kaanytr/ebkdrive/README.md

# ebkdrive
An open-source sensored BLDC controller board that integrates all necessary components into a compact form factor which is 65x65mm. I designed it to be a cost effective and reliable motor driver solution for e-bikes, scooters, skateboards etc.
The controller board integrates STM32 blackpill as the microcontroller. 
The buck converter on the board steps down 36V battery input to 5V for powering the microcontroller. And a step-up converter boosts that 5V to 12V in order to supply the gate driver ICs. 
For now, it runs on open loop speed control by using a potentiometer which can be substituted for a throttle lever. 
The board is designed to work with 36 V but, considering the the parts I have chosen, it should tolerate 48 V operation as well.

https://www.youtube.com/shorts/Ij17WwWdD78

Continious Current capacity : 15A without heat sinking ,
Peak Current : 30A

You can download and import the STM32CubeIDE project to edit to your liking. Or, you can directly flash the ebkdrive_v1.elf file that is found in the debug folder. In either case you have to determine your phase directions by trying different phase and hall sensor arrangements according to your motor. Automatic commutation detection is on the way!
I have the STM32F401CDU6 version of the black pill but software will work for other versions as well.
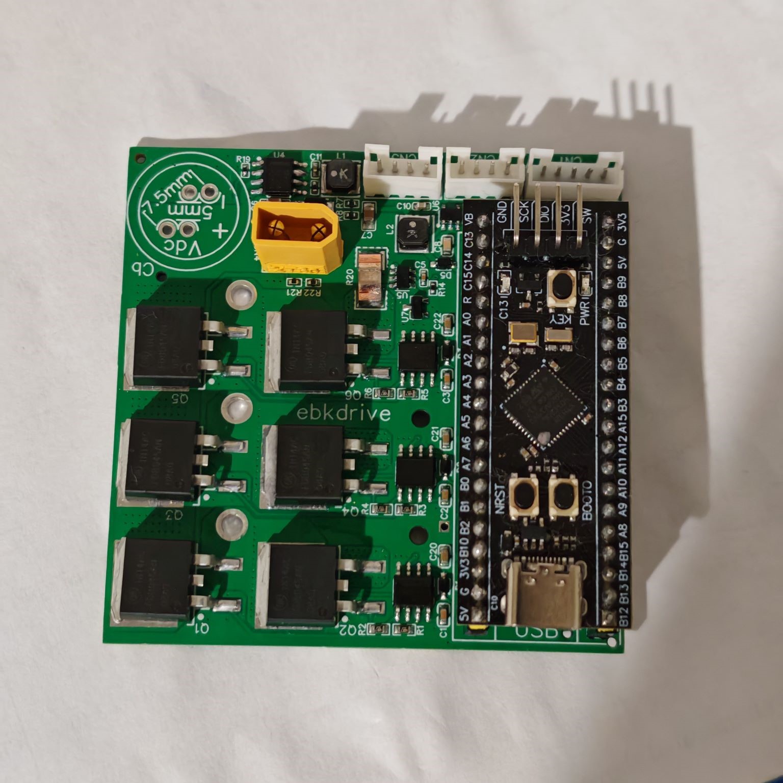
[picture p1: images/top_board.jpg]

 I ordered my PCB assembly from JLCPCB. I only ordered tiny capacitors, resistors and diodes to be pre soldered to the board to keep the special component fee low. Later, I soldered every other component by myself using hot air station and soldering paste. Nonetheless, you can order the PCB assembly as is even though some parts could be out of stock. Which one can substitute for pin-to-pin exactly same functioning parts. I recommend at least 470uF 63V electrolytic capacitor to be soldered for the bus capacitor. Both 5mm and 7.5mm capacitor lead spacing slots can be used. There are 2 M2 screw holes on the board which are intended for securing the board onto a housing. 
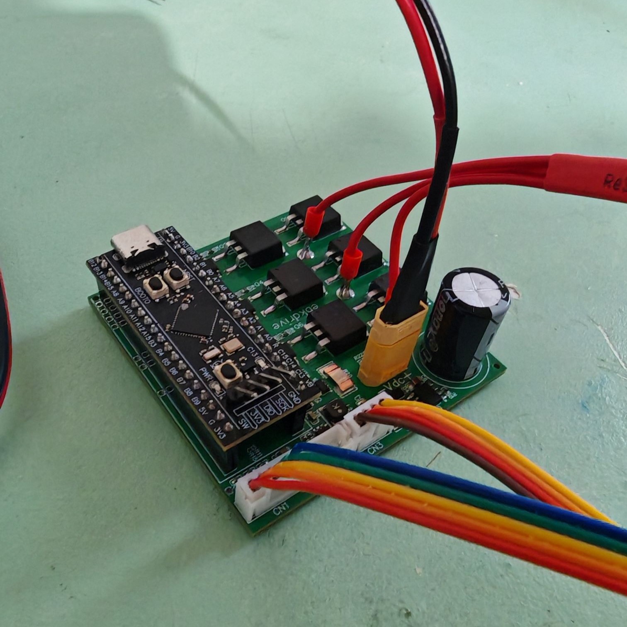
[picture p2: images/board_wired.jpg]
 
## Future scope :
  * Enabling regenerative braking
  * Integrating SSD1106 OLED screen interface to display real-time data, such as motor speed and power consumption. It's going to utilize I2C pins on the connector CN2.
  * Automatic commutation sequence recognition
