kaanytr/ebkdrive/images/3D.png

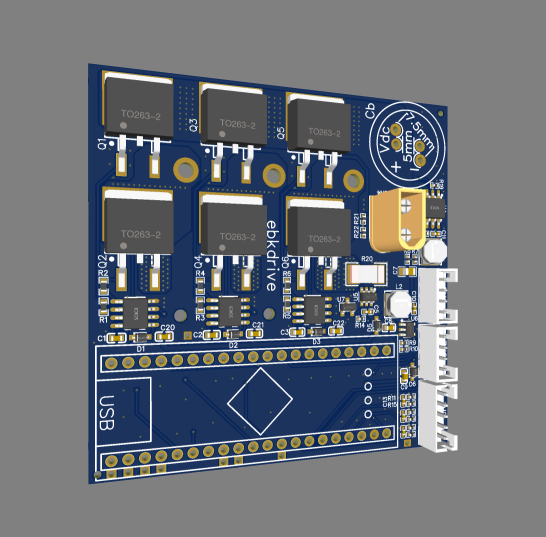
images/3D.png
