kaanytr/ebkdrive/images/board.jpg

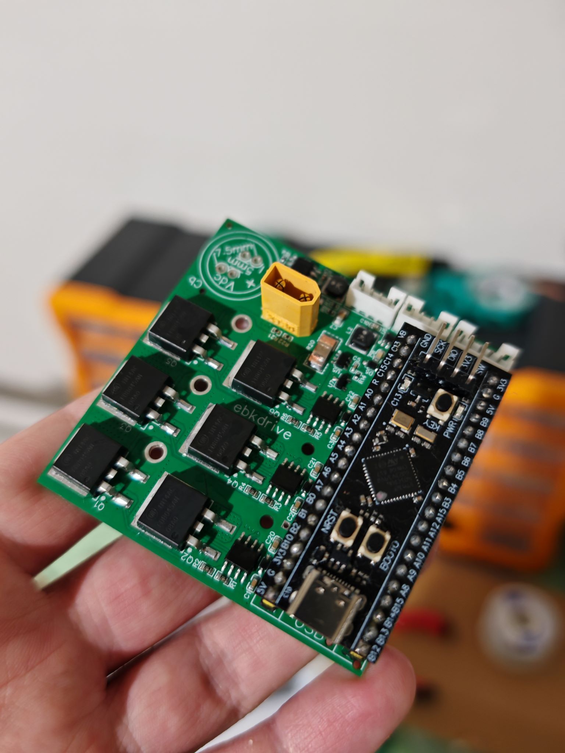
images/board.jpg
