kaanytr/ebkdrive/images/board_right.jpg

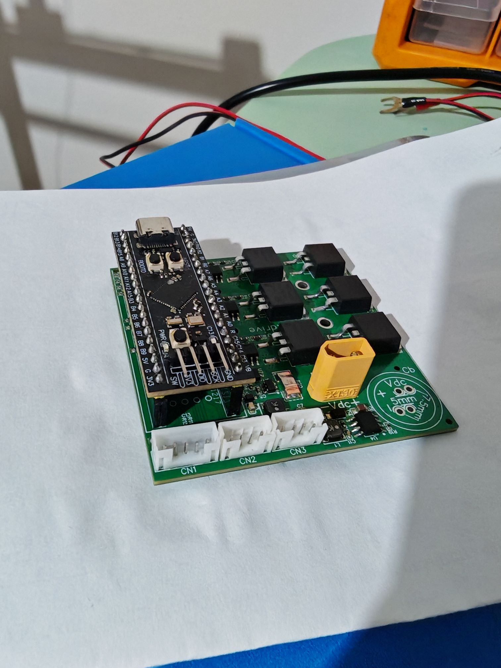
images/board_right.jpg
