kaanytr/ebkdrive/images/Bottom_layer.png

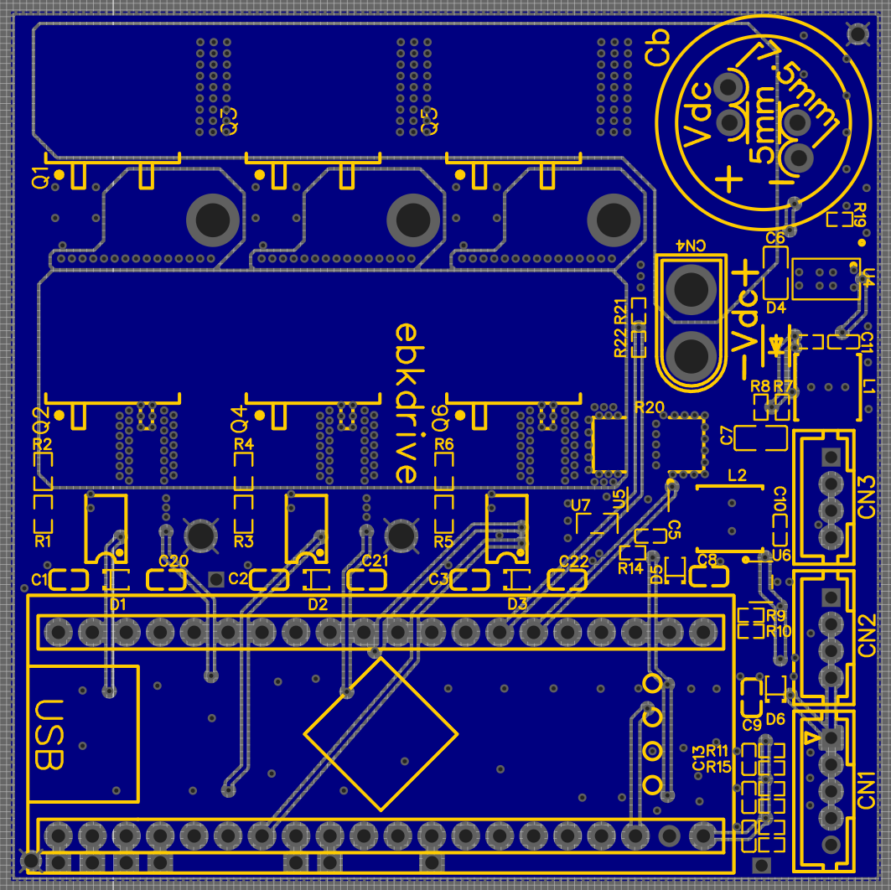
images/Bottom_layer.png
