kaanytr/ebkdrive/images/Top_layer.png

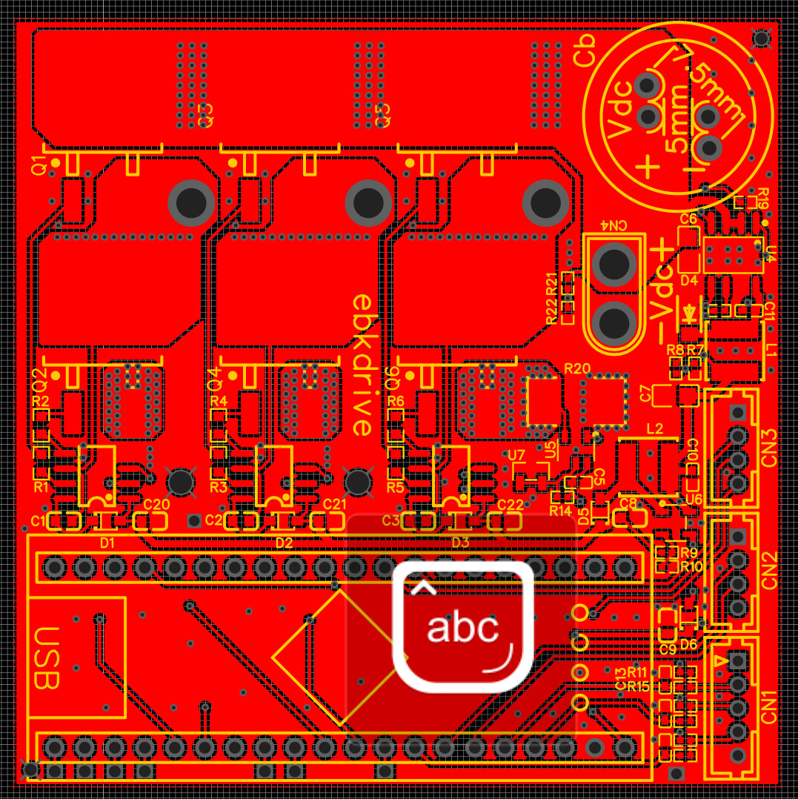
images/Top_layer.png
