kaanytr/ebkdrive/BOM_ebkdrive.ods

ID | Name | Designator | Footprint | Quantity | Manufacturer Part | Manufacturer | Supplier | Supplier Part
1 | 200kΩ | R9,R17 | R0402 | 2 | 0402WGF2003TCE | UNI-ROYAL(厚声) | LCSC | C25764
2 | 22kΩ | R10 | R0402 | 1 | 0402WGF2202TCE | UNI-ROYAL(厚声) | LCSC | C25768
3 | FDB045AN08 | Q1,Q2,Q3,Q4,Q5,Q6 | TO-263-3 | 6 | FDB045AN08 | ONS (FAIRCHILD) | LCSC
4 | IR2103STRPBF | U1,U2,U3 | SOIC-8_L5.0-W4.0-P1.27-LS6.0-BL | 3 | IR2103STRPBF | Infineon(英飞凌) | LCSC | C2957
5 | B5B-PH-K-S-(LF)(SN) | CN1 | CONN-TH_B5B-PH-K-S-LF-SN | 1 | B5B-PH-K-S(LF)(SN) | JST | LCSC | C157993
6 | XT30U-M | CN4 | CONN-TH_XT30U-M | 1 | XT30U-M | AMASS(艾迈斯) | LCSC | C99101
7 | 10uF | C6 | C0805 | 1 | GRM21BR61H106KE43L | muRata(村田) | LCSC | C440198
8 | 100nF | C5 | C0402 | 1 | CL05B104KB54PNC | SAMSUNG(三星) | LCSC | C307331
9 | 100nF | C11 | C0402 | 1 | CL05B104KO5NNNC | SAMSUNG(三星) | LCSC | C1525
10 | DSK36_C22466353 | D4 | SOD-123FL_L2.8-W1.9-LS3.7-RD | 1 | DSK36 | 宏迦橙 | LCSC | C22466353
11 | 4.7Ω | R2,R3,R4,R5,R6,R1 | R0603 | 6 | 0603WAF470KT5E | UNI-ROYAL(厚声) | LCSC | C23164
12 | 49.9kΩ | R19 | R0402 | 1 | 0402WGF4992TCE | UNI-ROYAL(厚声) | LCSC | C25897
13 | 4.7uF | C20,C21,C22 | C0603 | 3 | CL10A475KO8NNNC | SAMSUNG(三星) | LCSC | C19666
14 | 12kΩ | R7 | R0402 | 1 | 0402WGF1202TCE | UNI-ROYAL(厚声) | LCSC | C25752
15 | 68kΩ | R8 | R0402 | 1 | 0402WGF6802TCE | UNI-ROYAL(厚声) | LCSC | C36871
16 | 1N5819WS | D1,D2,D3,D5,D6 | SOD-323_L1.8-W1.3-LS2.5-RD | 5 | 1N5819WS | Hottech(合科泰) | LCSC | C191023
17 | 330pF | C13,C14,C15 | C0402 | 3 | CL05C331JB5NNNC | SAMSUNG(三星) | LCSC | C13533
18 | 2.2kΩ | R11,R12,R13 | R0402 | 3 | 0402WGF2201TCE | UNI-ROYAL(厚声) | LCSC | C25879
19 | 6.8kΩ | R15,R16,R18 | R0402 | 3 | 0402WGF6801TCE | UNI-ROYAL(厚声) | LCSC | C25917
20 | 510Ω | R14 | R0402 | 1 | 0402WGF5100TCE | UNI-ROYAL(厚声) | LCSC | C25123
21 | 22uF | C7 | C0805 | 1 | CL21A226MAQNNNE | SAMSUNG(三星) | LCSC | C45783
22 | 10uF | C8,C9 | C0603 | 2 | CL10A106MA8NRNC | SAMSUNG(三星) | LCSC | C96446
23 | 10uF | C10 | C0402 | 1 | CL05A106MQ5NUNC | SAMSUNG(三星) | LCSC | C15525
24 | 56kΩ | R21 | R0402 | 1 | 0402WGF5602TCE | UNI-ROYAL(厚声) | LCSC | C25796
25 | 3.3kΩ | R22 | R0402 | 1 | 0402WGF3301TCE | UNI-ROYAL(厚声) | LCSC | C25890
26 | 470nF | C1,C2,C3 | C0603 | 3 | CL10B474KA8NNNC | SAMSUNG(三星) | LCSC | C1623
27 | B4B-PH-K-S-(LF)(SN) | CN2,CN3 | CONN-TH_B4B-PH-K-S-LF-SN | 2 | B4B-PH-K-S-(LF)(SN) | JST Sales America | LCSC | C160257
