kaanytr/ebkdrive/schematics.pdf

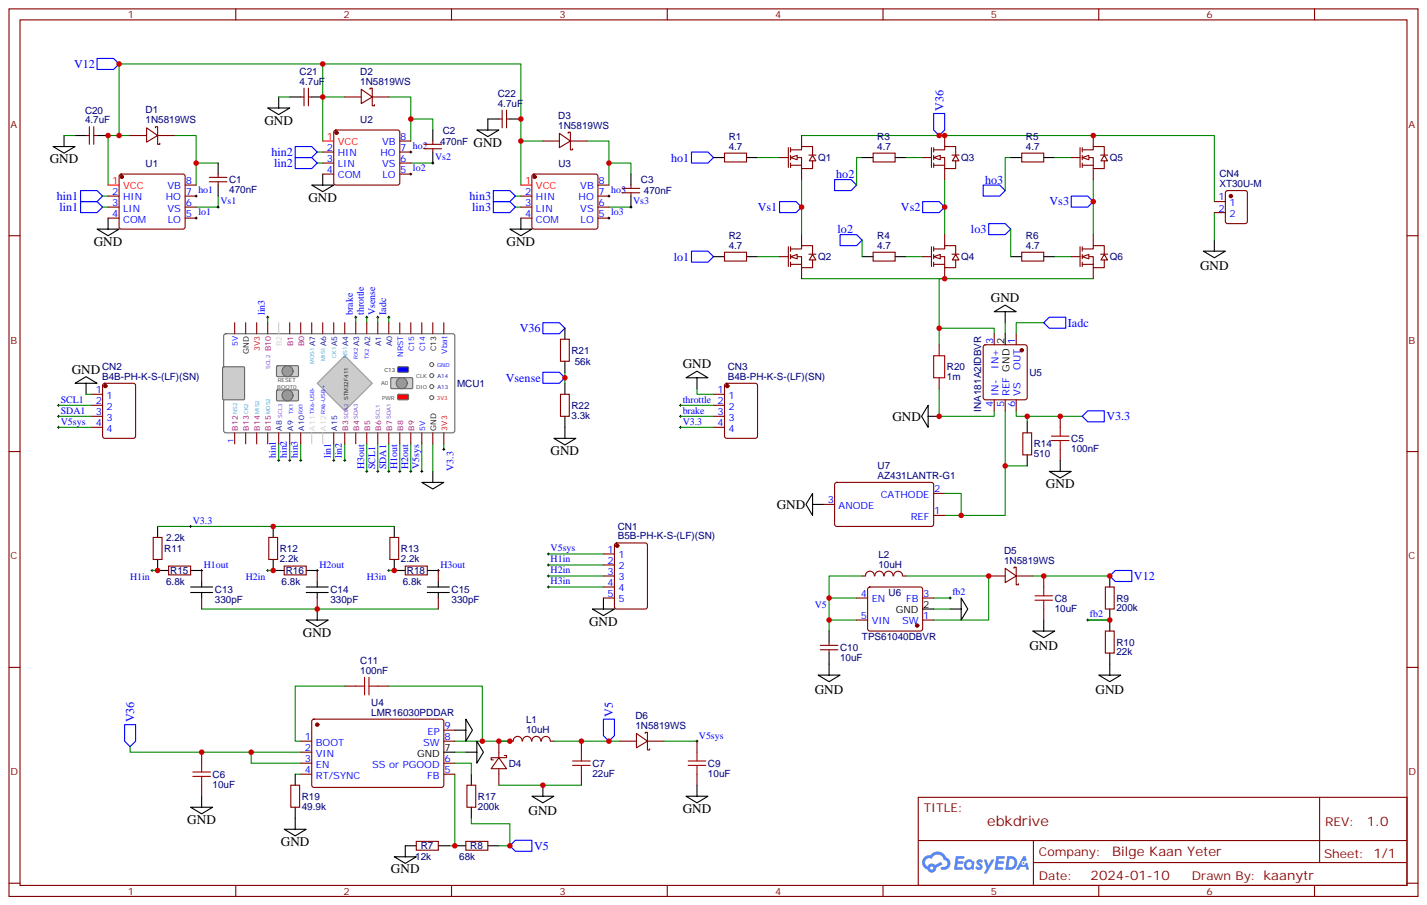
[picture p8: page 1]

Company: Bilge Kaan Yeter
