kaanytr/ebkdrive/images/unsoldered.jpg

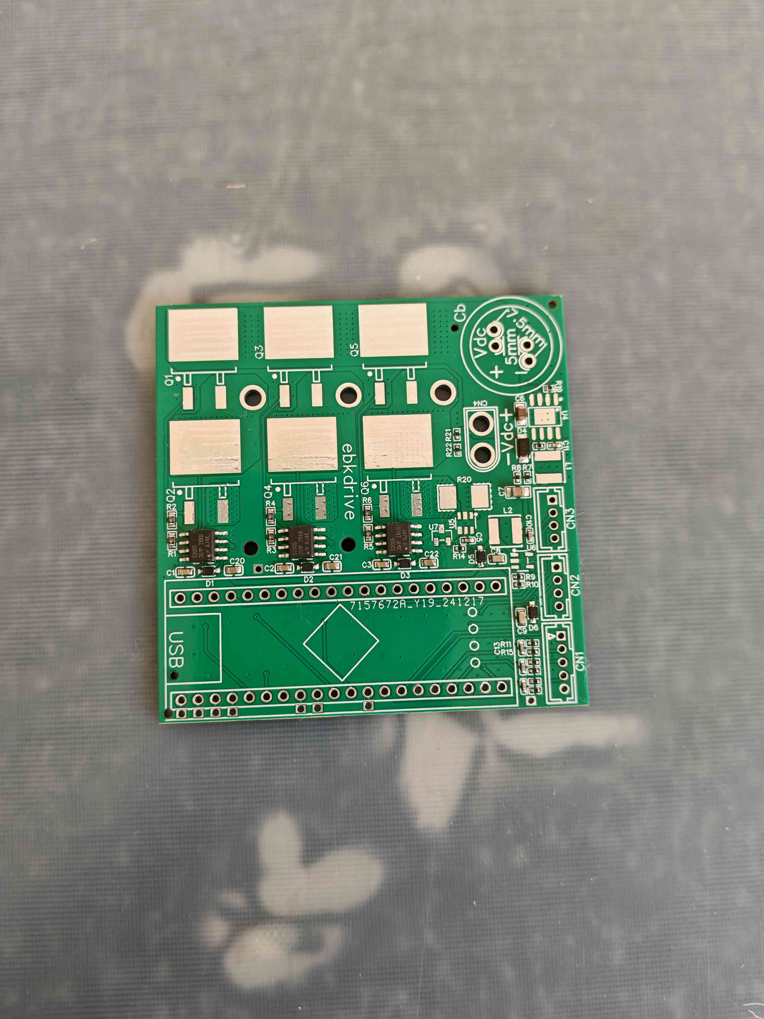
images/unsoldered.jpg
