kaanytr/ebkdrive/ebkdrive_v1/Core/Src/main.c

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
/* Includes ------------------------------------------------------------------*/
#include "main.h"

/* USER CODE BEGIN PD */
#define halla GPIO_PIN_8
#define hallb GPIO_PIN_9
#define hallc GPIO_PIN_5
/* USER CODE END PD */

ADC_HandleTypeDef hadc1;
DMA_HandleTypeDef hdma_adc1;

TIM_HandleTypeDef htim1;
TIM_HandleTypeDef htim3;

/* USER CODE BEGIN PV */
   uint8_t hallSensorState = 0b00000000;
   uint32_t buffer=0;
   uint32_t adc_val=0;
/* USER CODE END PV */

void SystemClock_Config(void);
static void MX_GPIO_Init(void);
static void MX_DMA_Init(void);
static void MX_TIM1_Init(void);
static void MX_TIM3_Init(void);
static void MX_ADC1_Init(void);
/* USER CODE BEGIN 0 */
void HAL_ADC_ConvCpltCallback(ADC_HandleTypeDef* hadc)
{
	if(buffer>50)
	{adc_val=buffer/4;}
    else
	adc_val=0;
}

void HAL_GPIO_EXTI_Callback(uint16_t GPIO_Pin)
{
	hallSensorState = 0;
    hallSensorState |= HAL_GPIO_ReadPin(GPIOB, GPIO_PIN_8) << 0;
    hallSensorState |= HAL_GPIO_ReadPin(GPIOB, GPIO_PIN_9) << 1;
    hallSensorState |= HAL_GPIO_ReadPin(GPIOB, GPIO_PIN_5) << 2;
}

void delay_us (uint16_t us)
{
	__HAL_TIM_SET_COUNTER(&htim3,0);  // set the counter value a 0
	while (__HAL_TIM_GET_COUNTER(&htim3) < us);  // wait for the counter to reach the us input in the parameter
}
/* USER CODE END 0 */

/**
  * @brief  The application entry point.
  * @retval int
  */
int main(void)
{

  /* MCU Configuration--------------------------------------------------------*/

  /* Reset of all peripherals, Initializes the Flash interface and the Systick. */
  HAL_Init();

  /* Configure the system clock */
  SystemClock_Config();

  /* Initialize all configured peripherals */
  MX_GPIO_Init();
  MX_DMA_Init();
  MX_TIM1_Init();
  MX_TIM3_Init();
  MX_ADC1_Init();
  /* USER CODE BEGIN 2 */

  HAL_TIM_PWM_Start(&htim1, TIM_CHANNEL_1);
  HAL_TIM_PWM_Start(&htim1, TIM_CHANNEL_2);
  HAL_TIM_PWM_Start(&htim1, TIM_CHANNEL_3);
HAL_TIM_Base_Start(&htim3);

  HAL_ADC_Start_DMA(&hadc1, &buffer, 1);
  /* USER CODE END 2 */

  /* Infinite loop */
  /* USER CODE BEGIN WHILE */
  while (1)
  {
   if(adc_val==0){
	                      __HAL_TIM_SET_COMPARE(&htim1, TIM_CHANNEL_1,0);
	   	  		    	  __HAL_TIM_SET_COMPARE(&htim1, TIM_CHANNEL_2,0);
	   	  	   	      	  __HAL_TIM_SET_COMPARE(&htim1, TIM_CHANNEL_3,0);
	   	  	   	  	  	  HAL_GPIO_WritePin(GPIOA, GPIO_PIN_15,1);
	   	  	   	  	  	  HAL_GPIO_WritePin(GPIOB, GPIO_PIN_3,1);
	   	  	   	  	      HAL_GPIO_WritePin(GPIOB, GPIO_PIN_10,1);
   }
	   switch (hallSensorState) {
	          case 0b00000001:
	        	  __HAL_TIM_SET_COMPARE(&htim1, TIM_CHANNEL_3,0);
	        	  delay_us(1);//deadtime
	              __HAL_TIM_SET_COMPARE(&htim1, TIM_CHANNEL_1,adc_val);
	              __HAL_TIM_SET_COMPARE(&htim1, TIM_CHANNEL_2,0);
	                HAL_GPIO_WritePin(GPIOA, GPIO_PIN_15,1);
	                HAL_GPIO_WritePin(GPIOB, GPIO_PIN_3,0);
	                HAL_GPIO_WritePin(GPIOB, GPIO_PIN_10,1);
	  	          break;
	  	      case 0b00000011:
	  	    	  __HAL_TIM_SET_COMPARE(&htim1, TIM_CHANNEL_1,adc_val);
	  	          __HAL_TIM_SET_COMPARE(&htim1, TIM_CHANNEL_2,0);
	  	          __HAL_TIM_SET_COMPARE(&htim1, TIM_CHANNEL_3,0);
	  	    		HAL_GPIO_WritePin(GPIOA, GPIO_PIN_15,1);
	  	    	    HAL_GPIO_WritePin(GPIOB, GPIO_PIN_3,1);
	  	    	  delay_us(1);//deadtime
	  	    		HAL_GPIO_WritePin(GPIOB, GPIO_PIN_10,0);
	  	          break;
	  	      case 0b00000010:
	  	    	  __HAL_TIM_SET_COMPARE(&htim1, TIM_CHANNEL_1,0);
	  	    	  delay_us(1);//deadtime
	  	    	  __HAL_TIM_SET_COMPARE(&htim1, TIM_CHANNEL_2,adc_val);
	  	          __HAL_TIM_SET_COMPARE(&htim1, TIM_CHANNEL_3,0);
	  	    	    HAL_GPIO_WritePin(GPIOA, GPIO_PIN_15,1);
	  	    	    HAL_GPIO_WritePin(GPIOB, GPIO_PIN_3,1);
	  	    	    HAL_GPIO_WritePin(GPIOB, GPIO_PIN_10,0);
	  	    	  break;
	  	      case 0b00000110:
	  	    	  __HAL_TIM_SET_COMPARE(&htim1, TIM_CHANNEL_1,0);
	  	    	  __HAL_TIM_SET_COMPARE(&htim1, TIM_CHANNEL_2,adc_val);
	  	          __HAL_TIM_SET_COMPARE(&htim1, TIM_CHANNEL_3,0);
	  	            HAL_GPIO_WritePin(GPIOB, GPIO_PIN_10,1);
	  	          delay_us(1);//deadtime
	  	    	    HAL_GPIO_WritePin(GPIOA, GPIO_PIN_15,0);
	  	    	    HAL_GPIO_WritePin(GPIOB, GPIO_PIN_3,1);

	  	      	  break;
	  	      case 0b00000100:
	  	    	  __HAL_TIM_SET_COMPARE(&htim1, TIM_CHANNEL_1,0);
	  	    	  __HAL_TIM_SET_COMPARE(&htim1, TIM_CHANNEL_2,0);
	  	    	  delay_us(1);//deadtime
	  	          __HAL_TIM_SET_COMPARE(&htim1, TIM_CHANNEL_3,adc_val);
	  	    	    HAL_GPIO_WritePin(GPIOA, GPIO_PIN_15,0);
	  	    	    HAL_GPIO_WritePin(GPIOB, GPIO_PIN_3,1);
	  	    	    HAL_GPIO_WritePin(GPIOB, GPIO_PIN_10,1);
	  	      	  break;
	  	      case 0b00000101:
	  	    	  __HAL_TIM_SET_COMPARE(&htim1, TIM_CHANNEL_1,0);
	  	    	  __HAL_TIM_SET_COMPARE(&htim1, TIM_CHANNEL_2,0);
	  	          __HAL_TIM_SET_COMPARE(&htim1, TIM_CHANNEL_3,adc_val);
	  	    	    HAL_GPIO_WritePin(GPIOA, GPIO_PIN_15,1);
	  	    	  delay_us(1);//deadtime
	  	    	    HAL_GPIO_WritePin(GPIOB, GPIO_PIN_3,0);
	  	    	    HAL_GPIO_WritePin(GPIOB, GPIO_PIN_10,1);
	  	      	  break;
	  	      case 0b00000000:
    	  	    	  __HAL_TIM_SET_COMPARE(&htim1, TIM_CHANNEL_1,0);
	  		    	  __HAL_TIM_SET_COMPARE(&htim1, TIM_CHANNEL_2,0);
	  	   	      	  __HAL_TIM_SET_COMPARE(&htim1, TIM_CHANNEL_3,0);
	  	   	  	  	  HAL_GPIO_WritePin(GPIOA, GPIO_PIN_15,1);
	  	   	  	  	  HAL_GPIO_WritePin(GPIOB, GPIO_PIN_3,1);
	  	   	  	      HAL_GPIO_WritePin(GPIOB, GPIO_PIN_10,1);
	  	   	  	    	  break;
	  	      case 0b11111111:
	   	  	    	  __HAL_TIM_SET_COMPARE(&htim1, TIM_CHANNEL_1,0);
	   	  	    	  __HAL_TIM_SET_COMPARE(&htim1, TIM_CHANNEL_2,0);
	   	  	    	  __HAL_TIM_SET_COMPARE(&htim1, TIM_CHANNEL_3,0);
	   	  	    	  HAL_GPIO_WritePin(GPIOA, GPIO_PIN_15,1);
	   	  	    	  HAL_GPIO_WritePin(GPIOB, GPIO_PIN_3,1);
	   	  	    	  HAL_GPIO_WritePin(GPIOB, GPIO_PIN_10,1);
	  	 	  	    	  break;
	  }
    /* USER CODE END WHILE */

    /* USER CODE BEGIN 3 */

  }
  /* USER CODE END 3 */
}

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
