kaanytr/ebkdrive/ebkdrive_v1/ebkdrive_v1.ioc

Mcu.UserName=STM32F401CDUx
PA10.Signal=S_TIM1_CH3
PA13.Signal=SYS_JTMS-SWDIO
PA14.Signal=SYS_JTCK-SWCLK
PA15.Signal=GPIO_Output
PA2.Signal=ADCx_IN2
PA3.Signal=ADCx_IN3
PA8.Signal=S_TIM1_CH1
PA9.Signal=S_TIM1_CH2
PB10.Signal=GPIO_Output
PB3.Signal=GPIO_Output
PB5.Signal=GPXTI5
PB8.Signal=GPXTI8
PB9.Signal=GPXTI9
