kaanytr/ebkdrive/(notices)

Notices in the files:
ebkdrive_v1/Core/Src/main.c:
Copyright (c) 2024 STMicroelectronics.
All rights reserved.
This software is licensed under terms that can be found in the LICENSE file
